Irophin/Thermique/Prototypes/Modeles 3D/Prototype - 02/Machine.jpg

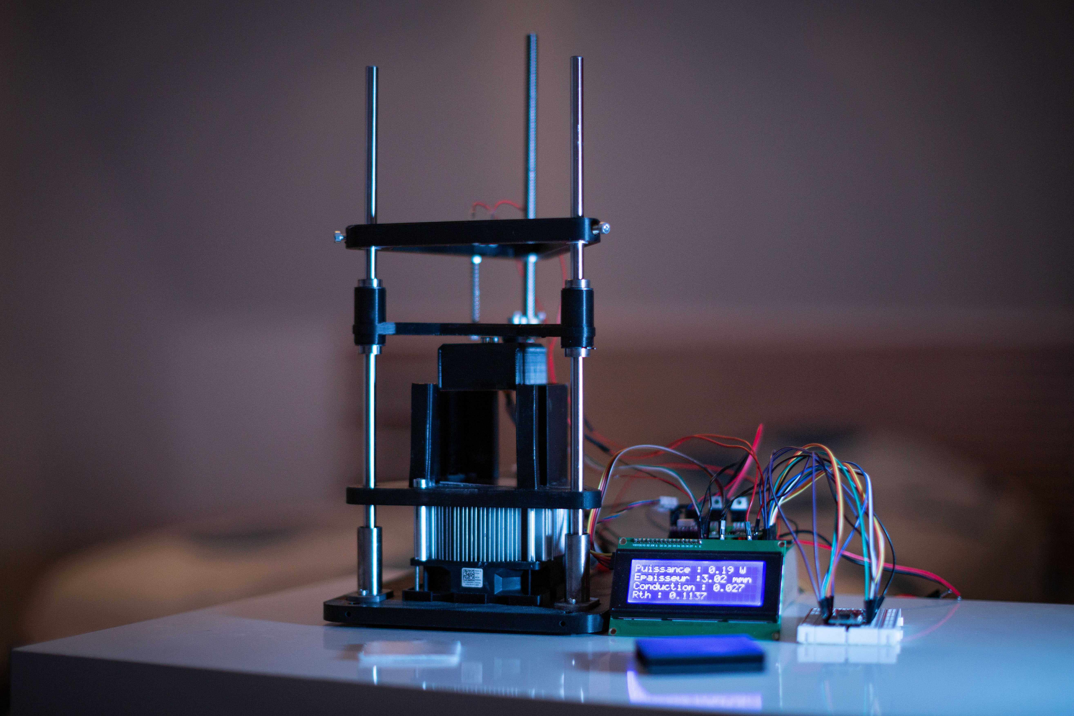
Prototypes/Modeles 3D/Prototype - 02/Machine.jpg
