Irophin/Thermique/Prototypes/Modeles 3D/Prototype - 02/PCB.jpg

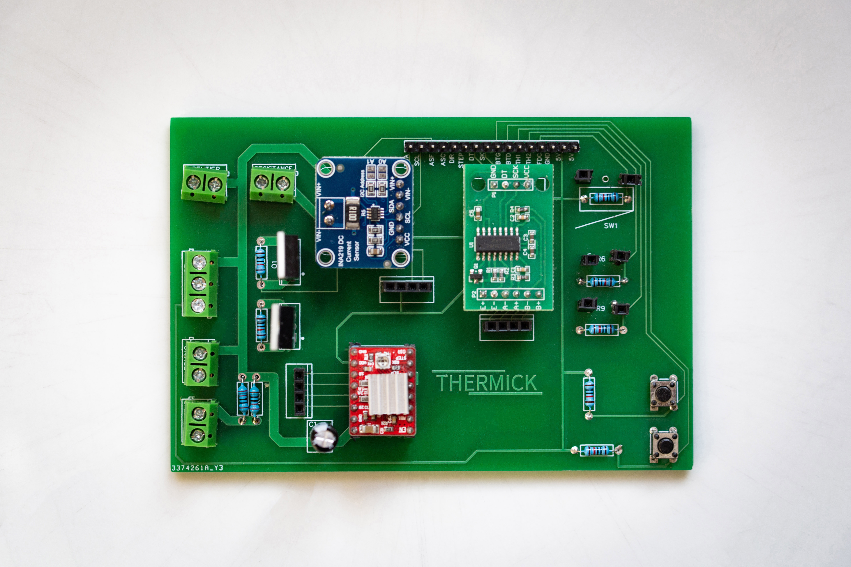
Prototypes/Modeles 3D/Prototype - 02/PCB.jpg
