Irophin/Thermique/README.md

<br>

# I.	Présentation

<p align="justify">
  &emsp;Le projet <strong>Thermique</strong> est une étude complète traitant la mesure de la résistance thermique des matériaux, c’est-à-dire la capacité d’un matériau à s’opposer à un flux de chaleur, plus cette résistance est élevée, plus le matériau est isolant. Pour ce faire, les architectes et ingénieurs utilisent une sonde à résistance thermique.<br>
  Cette recherche a pour objectif de concevoir une sonde à résistance thermique simple d’utilisation et économique afin de permettre simplement et à moindre frais d’étudier les différents matériaux et d’en déterminer le plus approprié pour l’isolation d’un bâtiment. Nous avons conçu plusieurs prototypes successifs, en cherchant dans un premier temps à automatiser le processus de mesure et de calcul, puis par la suite en cherchant à les minimiser et les optimiser, afin de proposer une expérience et précision optimales.
</p>

<br>

# II.	Genèse
  
<p align="justify">
  &emsp;Ce projet a été imaginé et réalisé dans le cadre des <strong>Olympiades de Physique 2021</strong> avec le soutien du <strong>lycée Gustave Eiffel</strong> de Dijon durant nos années de première et de terminal.<br>
  Tout au long de ces deux années, nous nous sommes confrontés à de nombreux obstacles tant  mécaniques, physiques ou même électroniques. Mais à force de rigueur, de persévérance et surtout de  travail nous avons finalement pu proposer 3 sondes chacune plus performante que la précédente. Vous trouverez un rapport détaillé de cette expérience dans le compte-rendu du projet : <a href = "https://github.com/BaudryLilian/Thermique/blob/main/Rapport%20-%20Projet%20Thermique.pdf">Rapport - Projet Thermique</a>.
</p>

<br>

# III.	Remerciements

<p align="justify">
  &emsp;Nous tenions à remercier M. <strong>CLÉMENCE</strong>, notre professeur référent, pour ses précieux conseils tout au long de ce projet qui nous ont permis de progresser et de découvrir les fondamentaux de la gestion d’un projet complexe.<br>
  Nous espérons par ailleurs poursuivre et compléter ce projet grâce aux nouveaux acquis de notre formation postbac (notions de thermodynamique, mécanique et informatique avancées) et même concrétiser les partenariats avec des ONG.
</p>
  
<br><br>

<div align="center">
	<table >
		<td align="center">
			<a href="https://github.com/Oxineo">Arthur <strong>MATEOS-MARTIN</strong></a></br>
			-</br>
  		Mécanique</br>
      Physique
    </td>
		<td align="center">
			&emsp;&emsp;<a href="https://github.com/BaudryLilian">Lilian <strong>BAUDRY</strong></a>&emsp;&emsp;<br>
  		-</br>
      <strong>Chef de projet</strong><br>
      Programmation
    </td>
		<td align="center">
  		&emsp;&emsp;<a href="https://github.com/SAMI-BL">Sami <strong>BLANDIN</strong></a>&emsp;&emsp;<br>
  		-</br>
      Communication<br>
      Rapport
    </td>
</table>
