Irophin/Thermique/Prototypes/Composants/Etalonnages/Jauge de Contrainte/Evolution de la contrainte.png

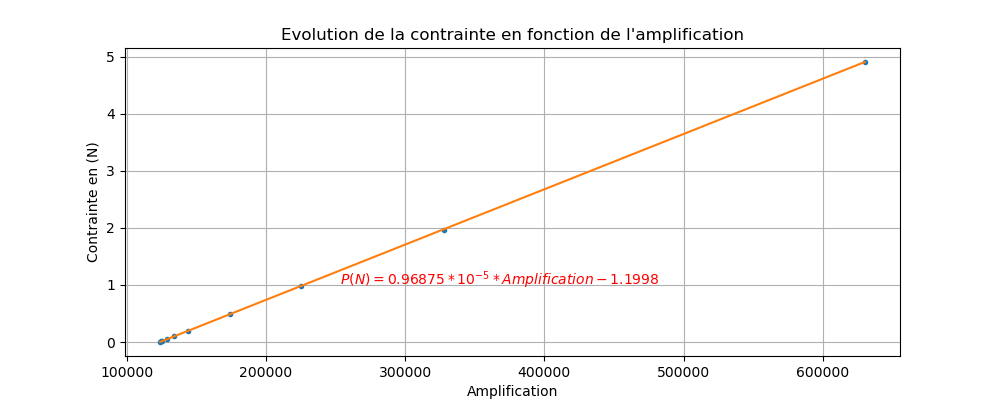
Prototypes/Composants/Etalonnages/Jauge de Contrainte/Evolution de la contrainte.png
