Irophin/Thermique/Prototypes/Composants/Etalonnages/Plaque de Peltier/Variation de peltier en fonction du temps.png

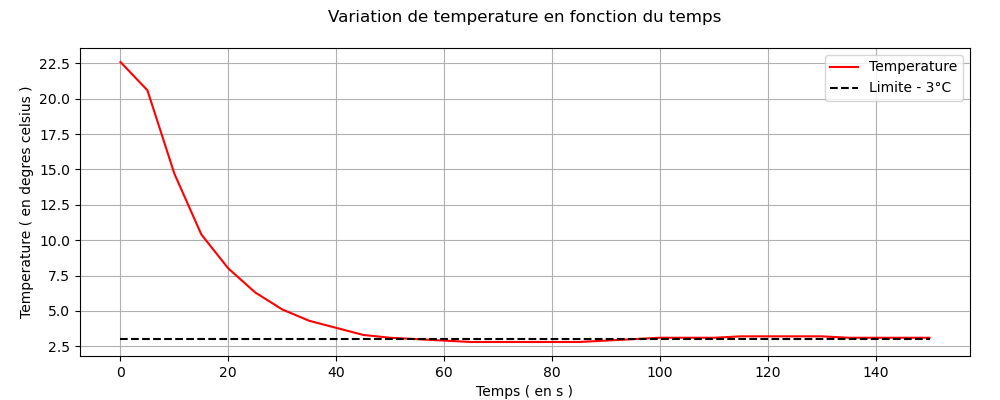
Prototypes/Composants/Etalonnages/Plaque de Peltier/Variation de peltier en fonction du temps.png
