Irophin/Thermique/Prototypes/Composants/Etalonnages/Resistance Chauffante/Variation température resistance.png

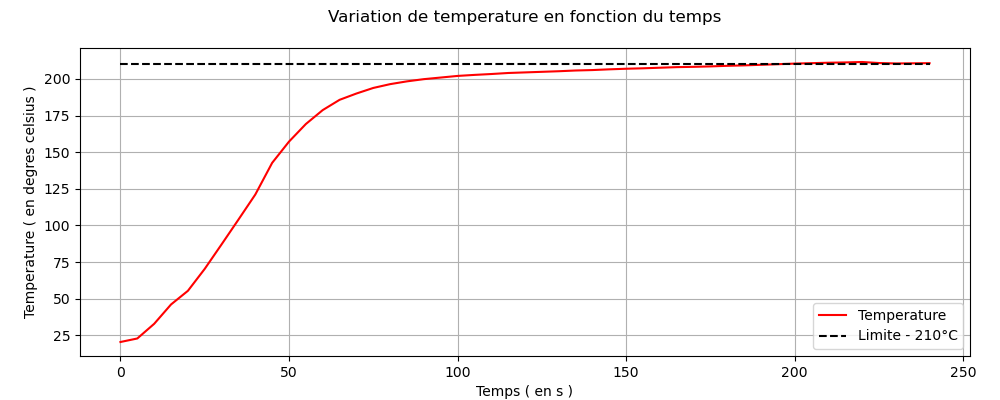
Prototypes/Composants/Etalonnages/Resistance Chauffante/Variation température resistance.png
