Irophin/Thermique/Prototypes/Composants/Etalonnages/Resistance Thermique/Courbe representative de la conductibilité thermique.png

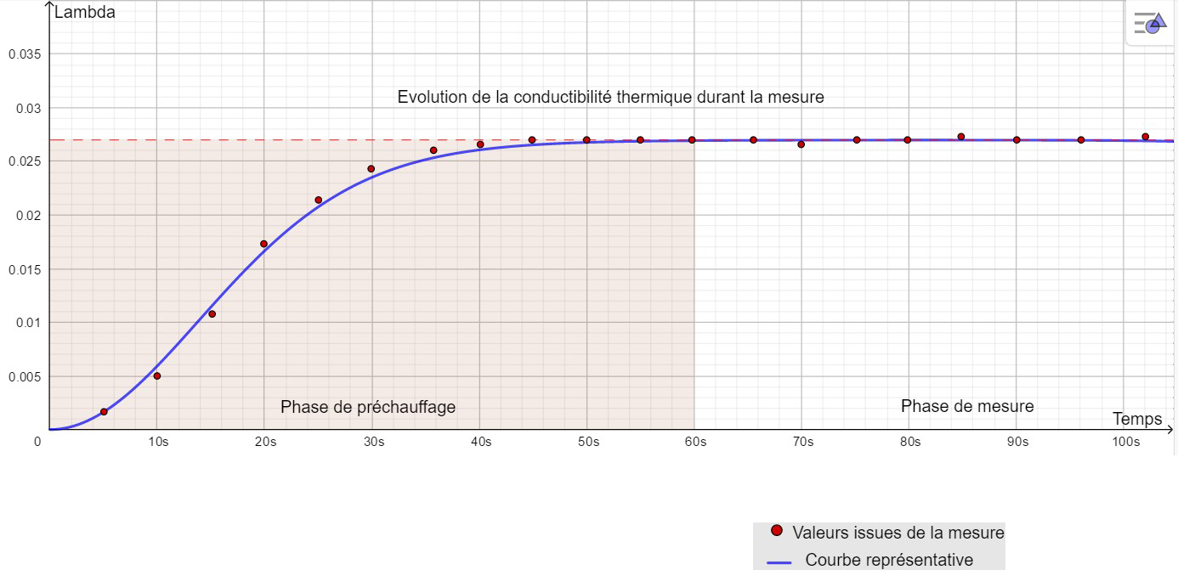
Prototypes/Composants/Etalonnages/Resistance Thermique/Courbe representative de la conductibilité thermique.png
