Irophin/Thermique/Prototypes/Composants/Etalonnages/Resistance Thermique/Incertitudes.jpeg

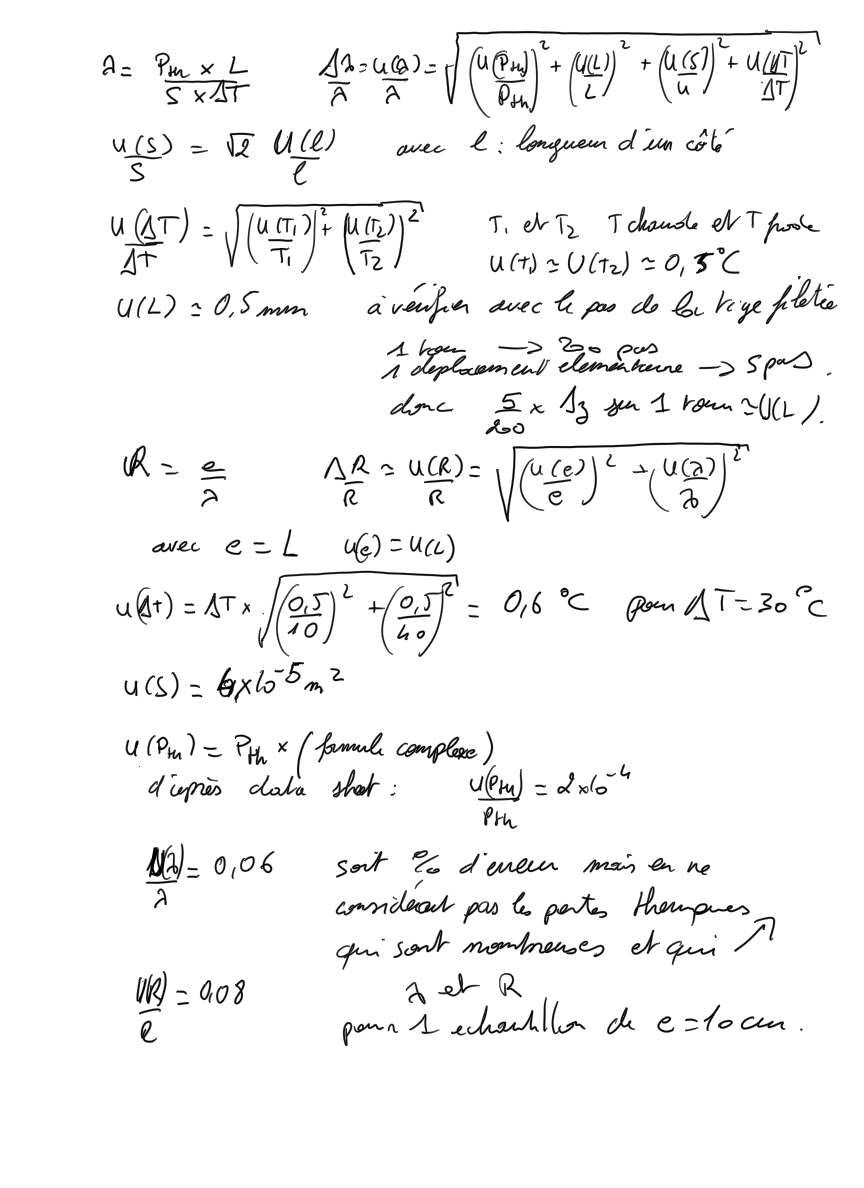
Prototypes/Composants/Etalonnages/Resistance Thermique/Incertitudes.jpeg
