Irophin/Thermique/Prototypes/Composants/Etalonnages/Themistances/thermistance graph. jpg.png

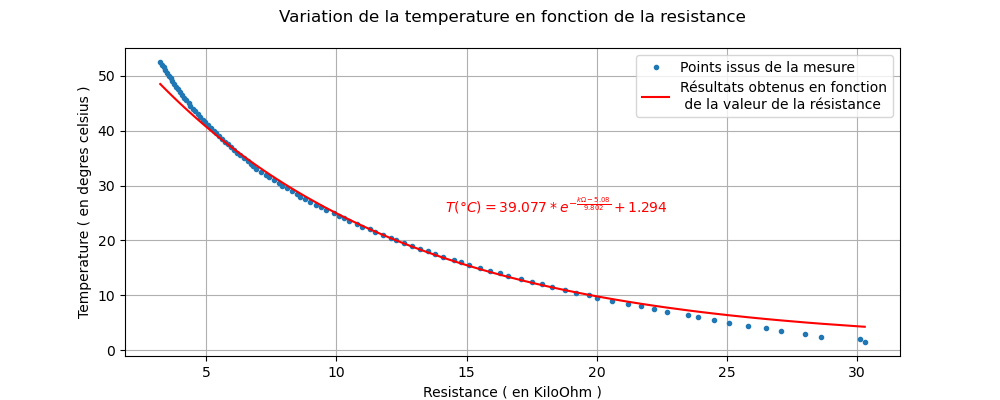
Prototypes/Composants/Etalonnages/Themistances/thermistance graph. jpg.png
