Irophin/Thermique/Prototypes/Composants/PCB/Version 2/Circuit imprimé  - Automatique.png

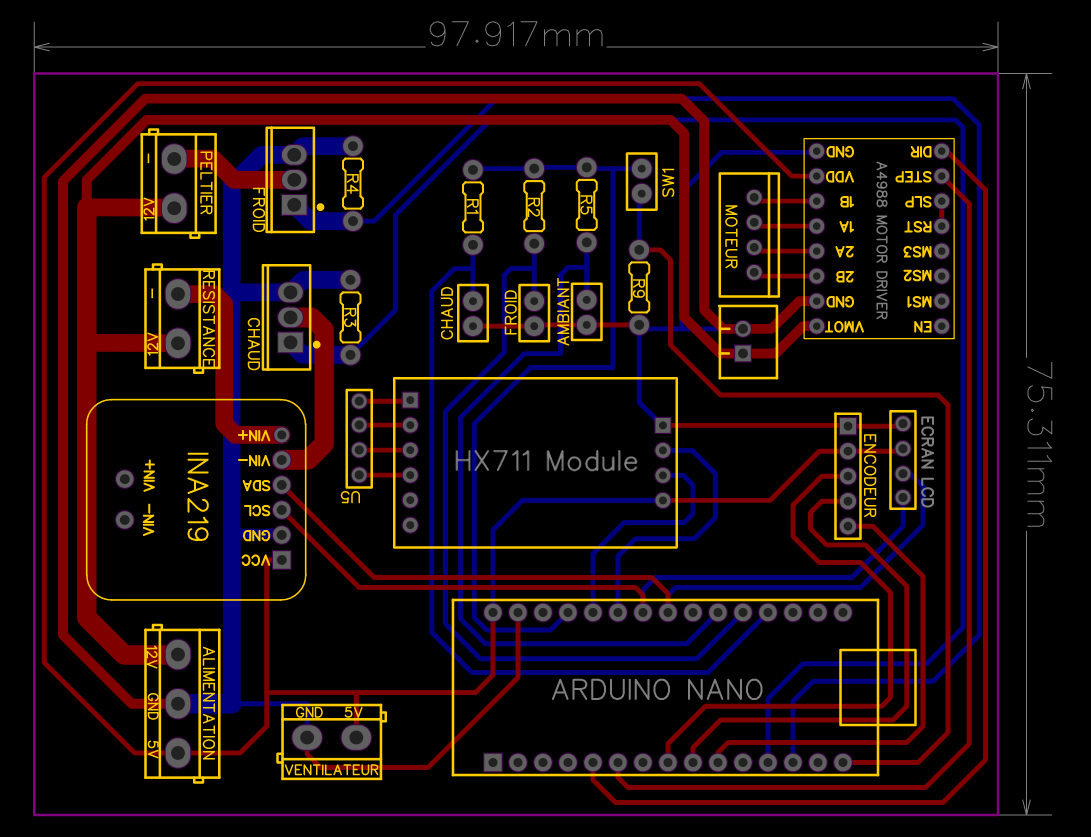
Prototypes/Composants/PCB/Version 2/Circuit imprimé - Automatique.png
