Irophin/Thermique/Prototypes/Composants/PCB/Version 2/Circuit imprimé  - Compact.png

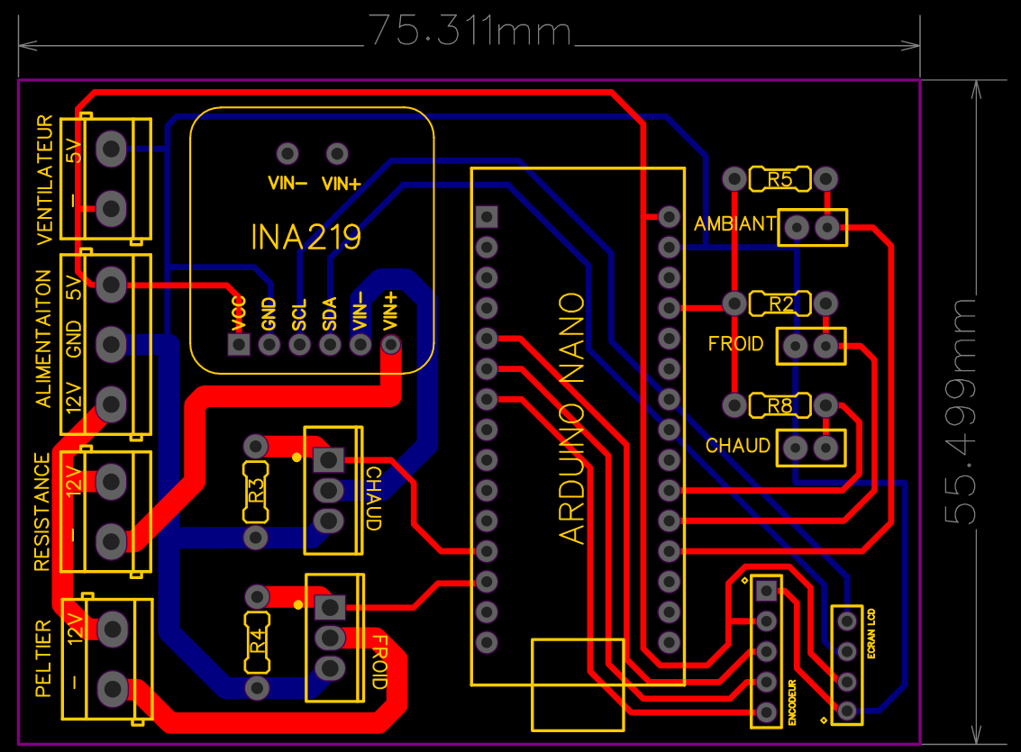
Prototypes/Composants/PCB/Version 2/Circuit imprimé - Compact.png
