Irophin/Thermique/Prototypes/Composants/PCB/Version 2/Schema éléctrique - Automatique.png

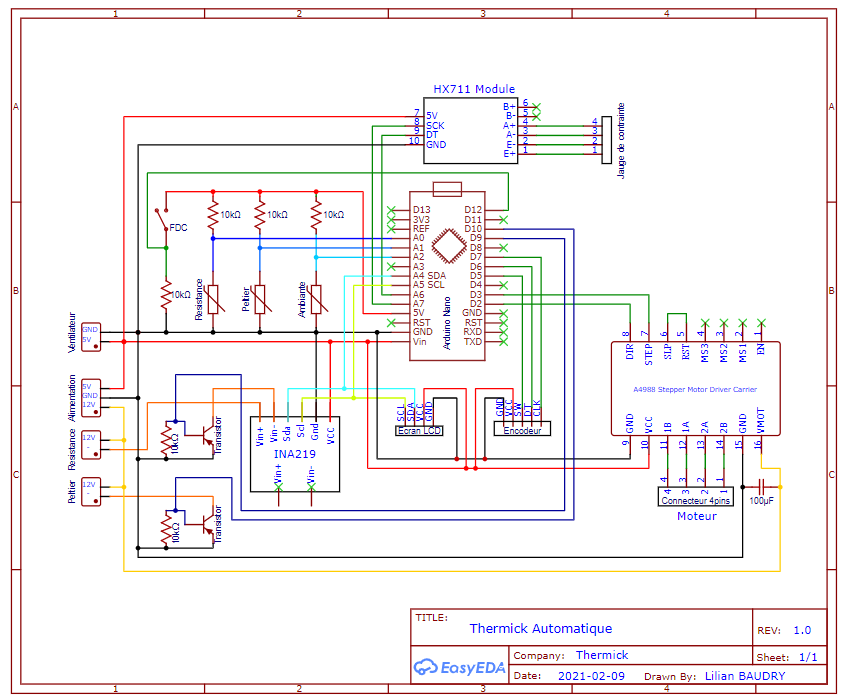
Prototypes/Composants/PCB/Version 2/Schema éléctrique - Automatique.png
