Irophin/Thermique/Prototypes/Composants/PCB/Version 2/Schema éléctrique - Compact.png

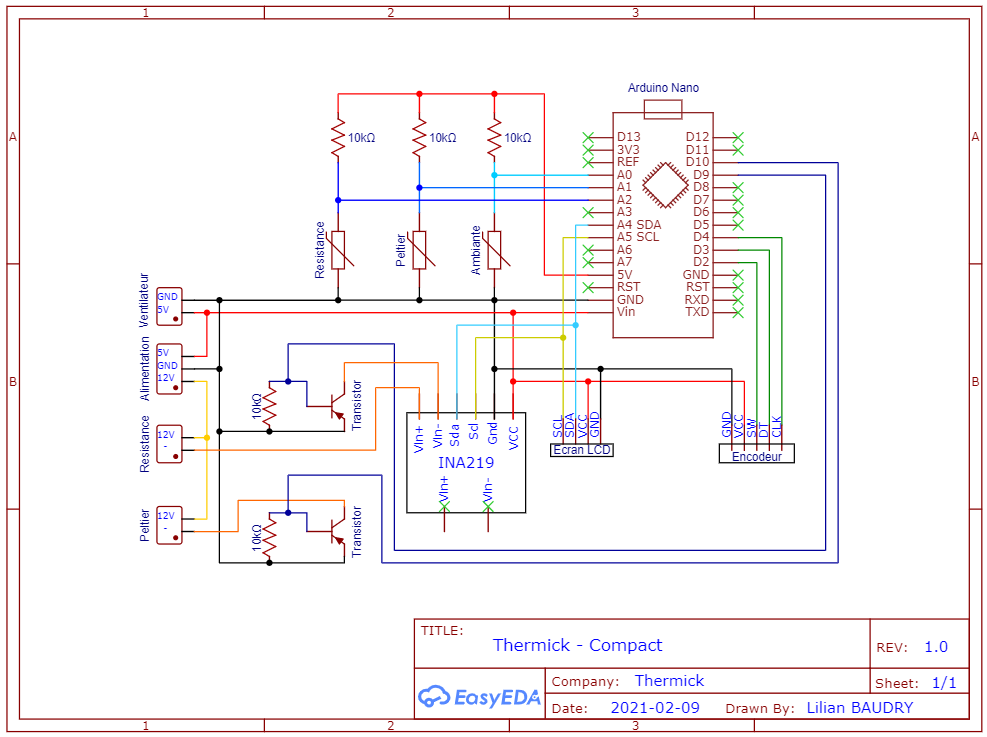
Prototypes/Composants/PCB/Version 2/Schema éléctrique - Compact.png
