Irophin/Thermique/Prototypes/Concept Art.jpg

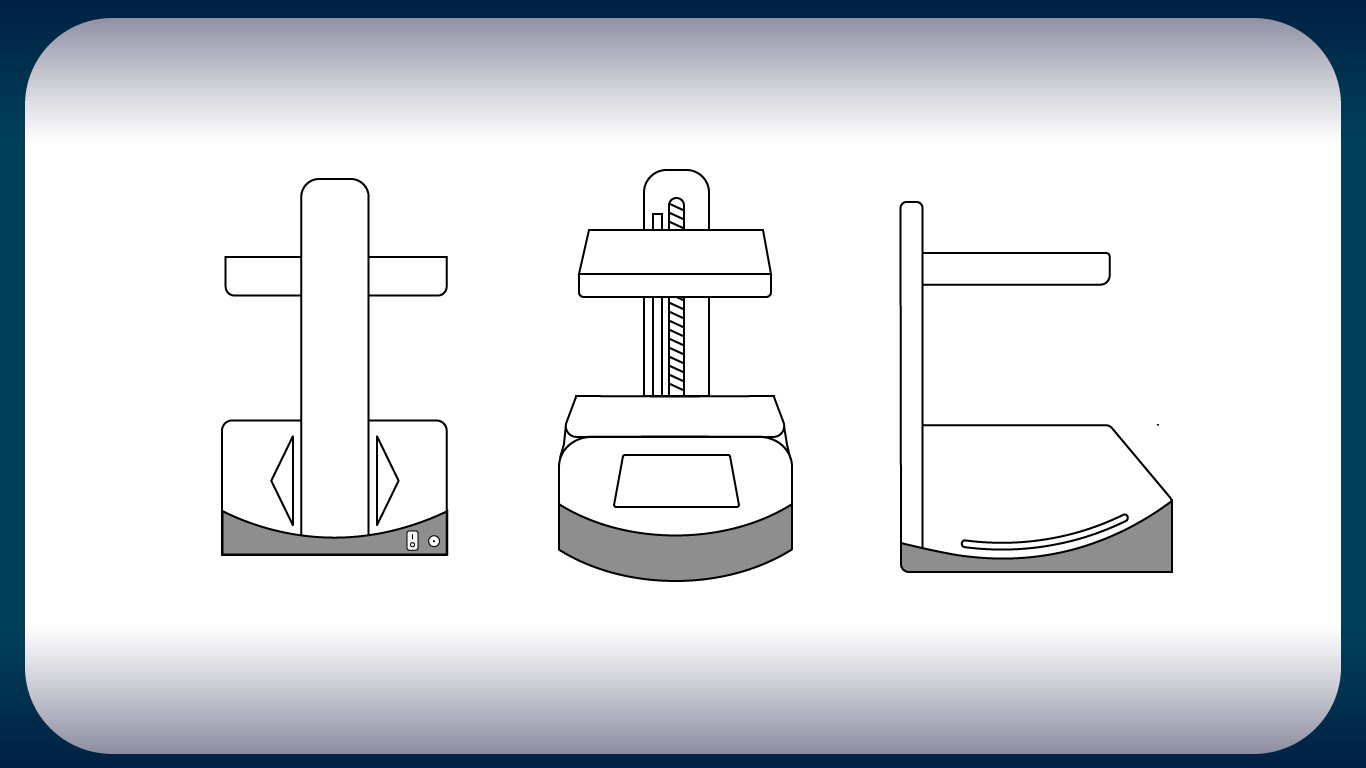
Prototypes/Concept Art.jpg
