Irophin/Thermique/Prototypes/Modeles 3D/Prototype - 01/Prototype 1.jpg

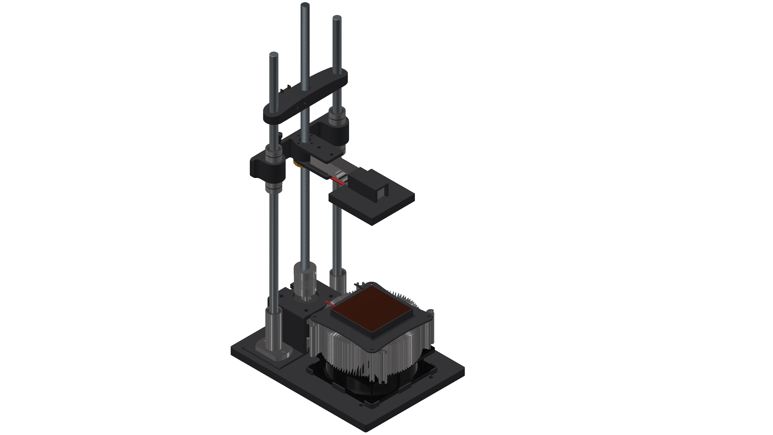
Prototypes/Modeles 3D/Prototype - 01/Prototype 1.jpg
