Irophin/Thermique/Prototypes/Modeles 3D/Prototype - 02/Prototype - 02.jpg

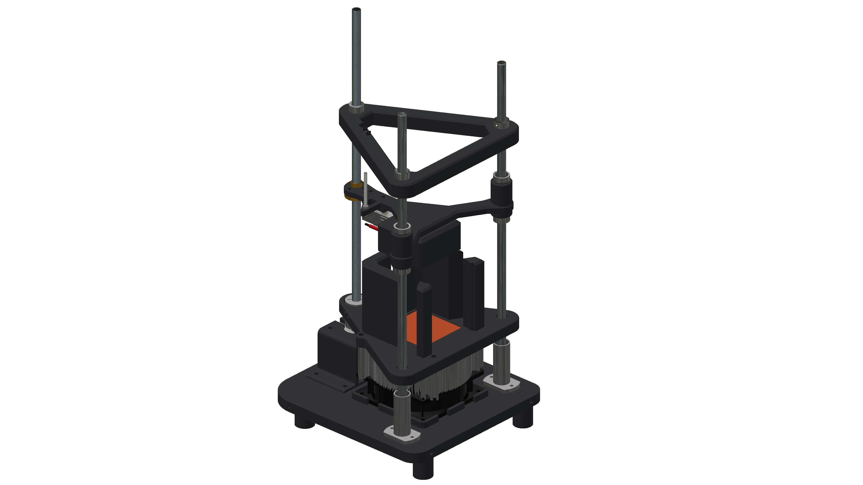
Prototypes/Modeles 3D/Prototype - 02/Prototype - 02.jpg
