Irophin/Thermique/Prototypes/Modeles 3D/Prototype - Compact/Prototype compact Arriere.jpg

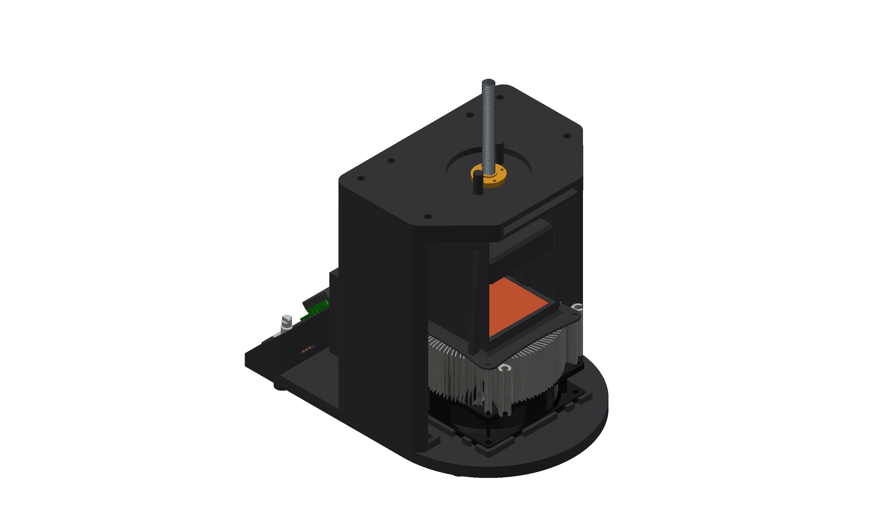
Prototypes/Modeles 3D/Prototype - Compact/Prototype compact Arriere.jpg
