Irophin/Thermique/Prototypes/Modeles 3D/Prototype - Compact/Prototype compact.jpg

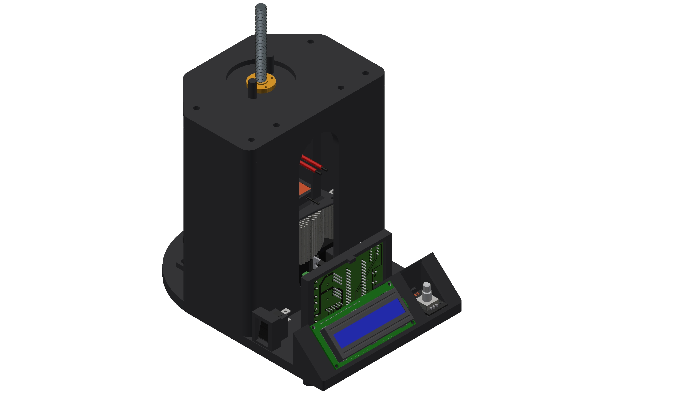
Prototypes/Modeles 3D/Prototype - Compact/Prototype compact.jpg
