Irophin/Thermique/Prototypes/Composants/Prix composants.xlsx

Prototype compact |  |  | Prototype n°3
Matériel | Prix | Lien | Matériel | Prix | Lien
Filament imprimante 3d | 5.00 € |  | Filament imprimante 3d | 5.00 €
Ecran LCD 16*2 | 7.99 € | Amazon (https://www.amazon.fr/AZDelivery-HD44780-1602-Module-afficheur-16-caract%C3%A8res-Arduino/dp/B07CQG6CMT) | Ecran LCD 16*2 | 7.99 € | Amazon (https://www.amazon.fr/AZDelivery-HD44780-1602-Module-afficheur-16-caract%C3%A8res-Arduino/dp/B07CQG6CMT)
Thermistance 10k | 7.99 € | Amazon | Thermistance 10k | 7.99 € | Amazon
Ventilateur ARCTIC F8 | 3.99 € | Amazon (https://www.amazon.fr/Arctic-Cooling-Pack-Ventilateurs-bo%C3%AEtier/dp/B002QVFN7G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) | Ventilateur ARCTIC F8 | 3.99 € | Amazon (https://www.amazon.fr/Arctic-Cooling-Pack-Ventilateurs-bo%C3%AEtier/dp/B002QVFN7G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)
Dissipateur Thermique | 5.99 € |  | Dissipateur Thermique | 5.99 €
Plaque de peltier | 7.99 € | Amazon (https://www.amazon.fr/sourcing-map-TEC1-12706-Radiateur-%C3%A9lectrique/dp/B07PQR8YTF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) | Plaque de peltier | 7.99 € | Amazon (https://www.amazon.fr/sourcing-map-TEC1-12706-Radiateur-%C3%A9lectrique/dp/B07PQR8YTF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)
Résistance de puissance | 7.38 € | Amazon (https://www.amazon.fr/dp/B07FJY4PCL/ref=twister_B07FKLHRHB?_encoding=UTF8&psc=1) | Résistance de puissance | 7.38 € | Amazon (https://www.amazon.fr/dp/B07FJY4PCL/ref=twister_B07FKLHRHB?_encoding=UTF8&psc=1)
Transistor de puissance | 3.67 € | Amazon (https://www.amazon.fr/Beauneo-IRFZ44N-IRFZ44-Transistor-Puissance/dp/B07ZFNT6XD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) | Transistor de puissance | 3.67 € | Amazon (https://www.amazon.fr/Beauneo-IRFZ44N-IRFZ44-Transistor-Puissance/dp/B07ZFNT6XD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)
Arduino Nano | 5.81 € | Amazon (https://www.amazon.fr/SODIAL-ATmega328-P-20AU-Carte-Module/dp/B00QPUEFNW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) | Arduino Nano | 5.81 € | Amazon (https://www.amazon.fr/SODIAL-ATmega328-P-20AU-Carte-Module/dp/B00QPUEFNW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)
Fil dupont | 3.89 € | Amazon (https://www.amazon.fr/Neuftech®-femelle-Dupont-Arduino-Breadboard/dp/B00M9XOCV4?__mk_fr_FR=ÅMÅŽÕÑ) | Fil dupont | 3.89 € | Amazon (https://www.amazon.fr/Neuftech®-femelle-Dupont-Arduino-Breadboard/dp/B00M9XOCV4?__mk_fr_FR=ÅMÅŽÕÑ)
Alimentation | 17.29 € | Amazon (https://www.amazon.fr/LEDMO-Convertisseur-Commutation-Alimentation-Informatique/dp/B01E6RMASC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) | Alimentation | 17.29 € | Amazon (https://www.amazon.fr/LEDMO-Convertisseur-Commutation-Alimentation-Informatique/dp/B01E6RMASC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)
Abaisseur de tension | 6.99 € | Amazon (https://www.amazon.fr/AZ-Delivery-Convertisseur-Abaisseur-affichage-num%C3%A9rique/dp/B08T158WPS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) | Abaisseur de tension | 6.99 € | Amazon (https://www.amazon.fr/AZ-Delivery-Convertisseur-Abaisseur-affichage-num%C3%A9rique/dp/B08T158WPS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)
Encodeur | 5.79 € | Amazon (https://www.amazon.fr/dp/B07TKK4QQD/ref=twister_B08213VRKL?_encoding=UTF8&psc=1) | Encodeur | 5.79 € | Amazon (https://www.amazon.fr/dp/B07TKK4QQD/ref=twister_B08213VRKL?_encoding=UTF8&psc=1)
Résistances 10kOhms | 2.33 € |  | Résistances 10kOhms | 2.33 €
Plaque de cuivre | 7.99 € | Amazon (https://www.amazon.fr/gp/product/B074V88T1J/ref=ox_sc_act_title_1?smid=A377Z8NE9XHCBB&psc=1) | Plaque de cuivre | 7.99 € | Amazon (https://www.amazon.fr/gp/product/B074V88T1J/ref=ox_sc_act_title_1?smid=A377Z8NE9XHCBB&psc=1)
INA 219 | 2.86 € | Amazon (https://www.amazon.fr/SODIAL-Ina219-bidirectionnel-devasion-dalimentation/dp/B01L1PGF9M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) | INA 219 | 2.86 € | Amazon (https://www.amazon.fr/SODIAL-Ina219-bidirectionnel-devasion-dalimentation/dp/B01L1PGF9M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)
Circuit imprimé | 4.97 € | JLCPCB (https://jlcpcb.com/b?msclkid=04b318414b7f110b91db787b6364876d) | Circuit imprimé | 4.97 € | JLCPCB (https://jlcpcb.com/b?msclkid=04b318414b7f110b91db787b6364876d)
Total | 107.92 € |  | Jauge de contrainte | 6.30 € | Amazon (https://www.amazon.fr/Aihasd-numérique-Portable-électronique-Capteurs/dp/B073GXMDNY?__mk_fr_FR=ÅMÅŽÕÑ)
 |  |  | Moteur pas-à-pas | 13.59 € | Amazon (https://www.amazon.fr/LEORX-NEMA-Phase-Moteur-imprimante/dp/B015ST2U5A?__mk_fr_FR=ÅMÅŽÕÑ)
 |  |  | Capteur de fin de course | 3.94 € | Amazon (https://www.amazon.fr/Fangfeen-Rouleau-commutateur-routeur-Imprimante/dp/B07WGNFXDV?__mk_fr_FR=ÅMÅŽÕÑ&s=industrial)
 |  |  | Total | 131.75 €
